kuellenberg/NRF24Stick/README.md

# NRF24Stick

nRF24L01+ Test Board
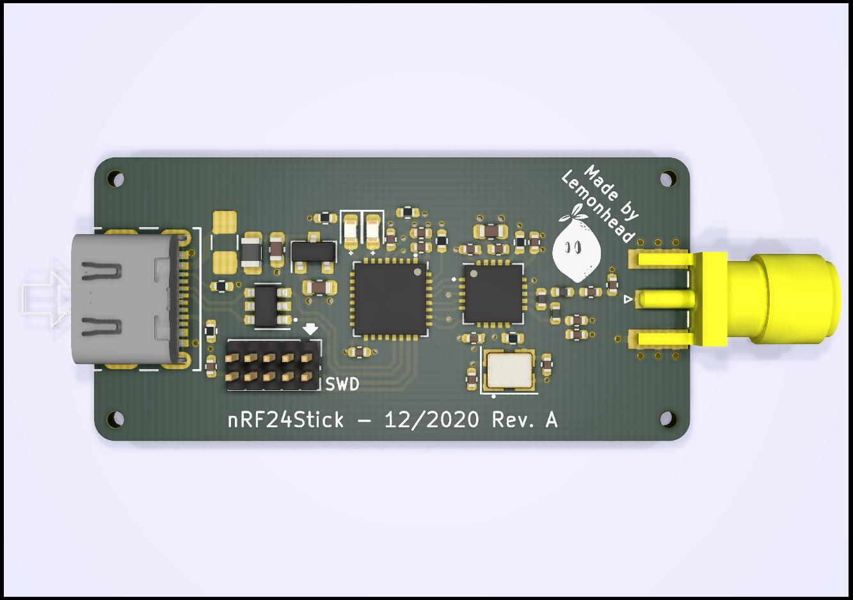
[picture p1: NRF24Stick.jpg]
NRF24Stick
