kuellenberg/NRF24Stick/NRF24Stick.kicad_pcb

## KiCad design NRF24Stick.kicad_pcb (2020-12-13)

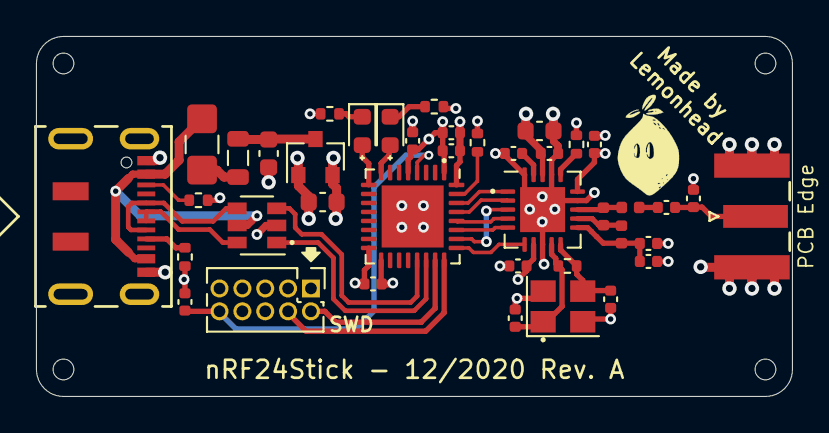
[picture p2: board NRF24Stick.kicad_pcb from above]

Board: 4 copper layers, 42.0 x 20.0 mm, 44 parts (0 on the bottom side), 34 nets.

Parts:
C1: 1uF; C_0402_1005Metric
C2, C3, C4, C7: 100nF; C_0402_1005Metric
C5, C6, C18: 10uF; C_0603_1608Metric
C8, C9: 10nF; C_0402_1005Metric
C10: 33nF; C_0402_1005Metric
C11: 1nF; C_0402_1005Metric
C12, C14: 12pF; C_0402_1005Metric
C13: 2.2nF; C_0402_1005Metric
C15: 4.7pF; C_0402_1005Metric
C16: 1.5pF; C_0402_1005Metric
C17: 1.0pF; C_0402_1005Metric
F1: 100mA; Fuse_1206_3216Metric_Castellated
FB1: 100R @ 100MHz; L_0805_2012Metric
H1, H2, H3, H4: MountingHole; JLCPCB Tooling Hole
J1: SWD; PinHeader_2x05_P1.27mm_Vertical
J2: USB_C_Receptacle_USB2.0; DX07S016JA3R1500
J3: SMA; SMA_Samtec_SMA-J-P-H-ST-EM1_EdgeMount
L1: 8.2nH; L_0402_1005Metric
L2: 2.7nH; L_0402_1005Metric
L3: 3.9nH; L_0402_1005Metric
LD1: GR; LED_0603_1608Metric
LD2: YE; LED_0603_1608Metric
R1, R2: 1k; R_0402_1005Metric
R3, R4: 22k; R_0402_1005Metric
R5: 1M; R_0402_1005Metric
R6, R7: 5k1; R_0402_1005Metric
U1: XC6206P332MR; SOT-23
U2: USBLC6-2SC6; SOT-23-6
U3: STM32L432KBUx; QFN-32-1EP_5x5mm_P0.5mm_EP3.45x3.45mm
U4: nRF24L01P; QFN-20-1EP_4x4mm_P0.5mm_EP2.5x2.5mm
Y1: 16MHz; Crystal_SMD_3225-4Pin_3.2x2.5mm

Connections:
+3V3: C1.1, C2.1, C3.1, C4.1, C6.1, C8.2, C9.2, C11.2, C18.1, J1.1, U1.2, U3.1, U3.5, U3.17, U4.7, U4.15, U4.18
+5V: F1.2, J2.A4, J2.A9, U2.5
/ANT1: L1.1, L2.1, U4.12
/ANT2: L1.2, L3.2, U4.13
/ANT_OUT: C16.1, C17.2, J3.1
/DVDD: C10.2, U4.19
/IREF: R4.1, U4.16
/LED_GR: LD1.2, U3.9
/LED_YE: LD2.2, U3.8
/NRF_CE: U3.30, U4.1
/NRF_CSN: U3.29, U4.2
/NRF_IRQ: U3.25, U4.6
/NRST: C7.2, J1.10, U3.4
/SPI_MISO: U3.27, U4.5
/SPI_MOSI: U3.28, U4.4
/SPI_SCK: U3.26, U4.3
/SWCLK: J1.4, U3.24
/SWDIO: J1.2, U3.23
/USB_CONN_D+: J2.A6, J2.B6, U2.6
/USB_CONN_D-: J2.A7, J2.B7, U2.4
/USB_D+: U2.1, U3.22
/USB_D-: U2.3, U3.21
/VDD_PA: C13.1, C15.1, L2.2, U4.11
/XC1: C14.1, R5.1, U4.10, Y1.3
/XC2: C12.1, R5.2, U4.9, Y1.1
GND: C1.2, C2.2, C3.2, C4.2, C5.2, C6.2, C7.1, C8.1, C9.1, C10.1, C11.1, C12.2, C13.2, C14.2, C15.2, C17.1, C18.2, J1.3, J1.5, J1.9, J2.A1, J2.A12, J3.2, R1.2, R2.2, R3.2, R4.2, R6.1, R7.1, U1.1, U2.2, U3.16, U3.32, U3.33, U4.8, U4.14, U4.17, U4.20, U4.21, Y1.2, Y1.4
unnamed: C5.1, FB1.1, U1.3
unnamed: C16.2, L3.1
unnamed: F1.1, FB1.2
unnamed: J2.A5, R6.2
unnamed: J2.B5, R7.2
unnamed: LD1.1, R1.1
unnamed: LD2.1, R2.1
unnamed: R3.1, U3.31
