kuellenberg/NRF24Stick/NRF24Stick Firmware/Core/Src/main.c

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
/* Includes ------------------------------------------------------------------*/
#include "main.h"
#include "usb_device.h"

/* USER CODE BEGIN Includes */
#include "usbd_cdc_if.h"
#include "nrf24.h"
/* USER CODE END Includes */

SPI_HandleTypeDef hspi1;

void SystemClock_Config(void);
static void MX_GPIO_Init(void);
static void MX_SPI1_Init(void);
/**
  * @brief  The application entry point.
  * @retval int
  */
int main(void)
{
  /* MCU Configuration--------------------------------------------------------*/

  /* Reset of all peripherals, Initializes the Flash interface and the Systick. */
  HAL_Init();

  /* Configure the system clock */
  SystemClock_Config();

  /* Initialize all configured peripherals */
  MX_GPIO_Init();
  MX_USB_DEVICE_Init();
  MX_SPI1_Init();
  /* USER CODE BEGIN 2 */

  uint8_t txBuf[64];
  uint8_t count;
  uint8_t s;

  nRF24_Init(&hspi1);


  /* USER CODE END 2 */

  /* Infinite loop */
  /* USER CODE BEGIN WHILE */
  while (1)
  {
    /* USER CODE END WHILE */

    /* USER CODE BEGIN 3 */
	  HAL_GPIO_TogglePin(LED_YE_GPIO_Port, LED_YE_Pin);
	  HAL_GPIO_TogglePin(LED_GR_GPIO_Port, LED_GR_Pin);
	  //s = nRF24_GetStatus();
	  s = nRF24_ReadRegister(nRF24_REG_RF_CH);
	  nRF24_SetRFChannel(1);
	  sprintf(txBuf,"Status: %d\n", s);
	  CDC_Transmit_FS(txBuf, strlen(txBuf));
	  HAL_Delay(500);

  }
  /* USER CODE END 3 */
}

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
