kuellenberg/NRF24Stick/NRF24Stick Firmware/Core/Inc/main.h

#define LED_YE_Pin GPIO_PIN_2
#define LED_YE_GPIO_Port GPIOA
#define LED_GR_Pin GPIO_PIN_3
#define LED_GR_GPIO_Port GPIOA
#define NRF_IRQ_Pin GPIO_PIN_15
#define NRF_IRQ_GPIO_Port GPIOA
#define NRF_CSN_Pin GPIO_PIN_6
#define NRF_CSN_GPIO_Port GPIOB
#define NRF_CE_Pin GPIO_PIN_7
#define NRF_CE_GPIO_Port GPIOB
